Michaleq24/Lokalizator-GPS-GSM/README.md

Katalog zawiera dokumentację i pliki związane z projektem "Lokalizator GPS/GSM".

Autor: Michał Figołuszka  INF s.5 gr.2
