Michaleq24/Lokalizator-GPS-GSM/Dokumentacja/Lokalizator.GPS.GSM_Michał.Figołuszka.pptx

## Lokalizator GPS/GSM

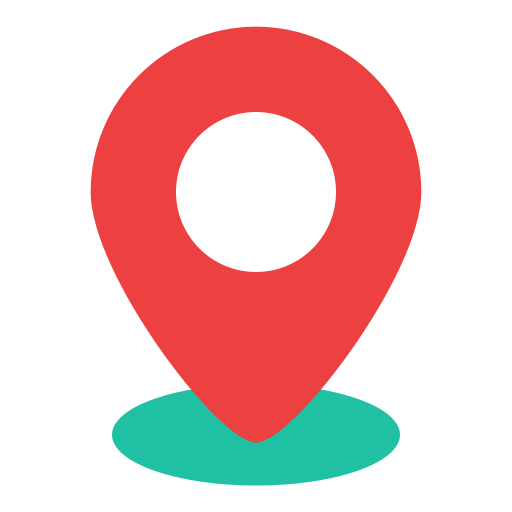
[picture p1: figure]
Map Pin - Free maps and location icons

## Środowisko programistyczne

- STM32CubeIDE 1.19.0
- Język: C++
- Mikrokontroler:
STM32 NUCLEO-L432KC

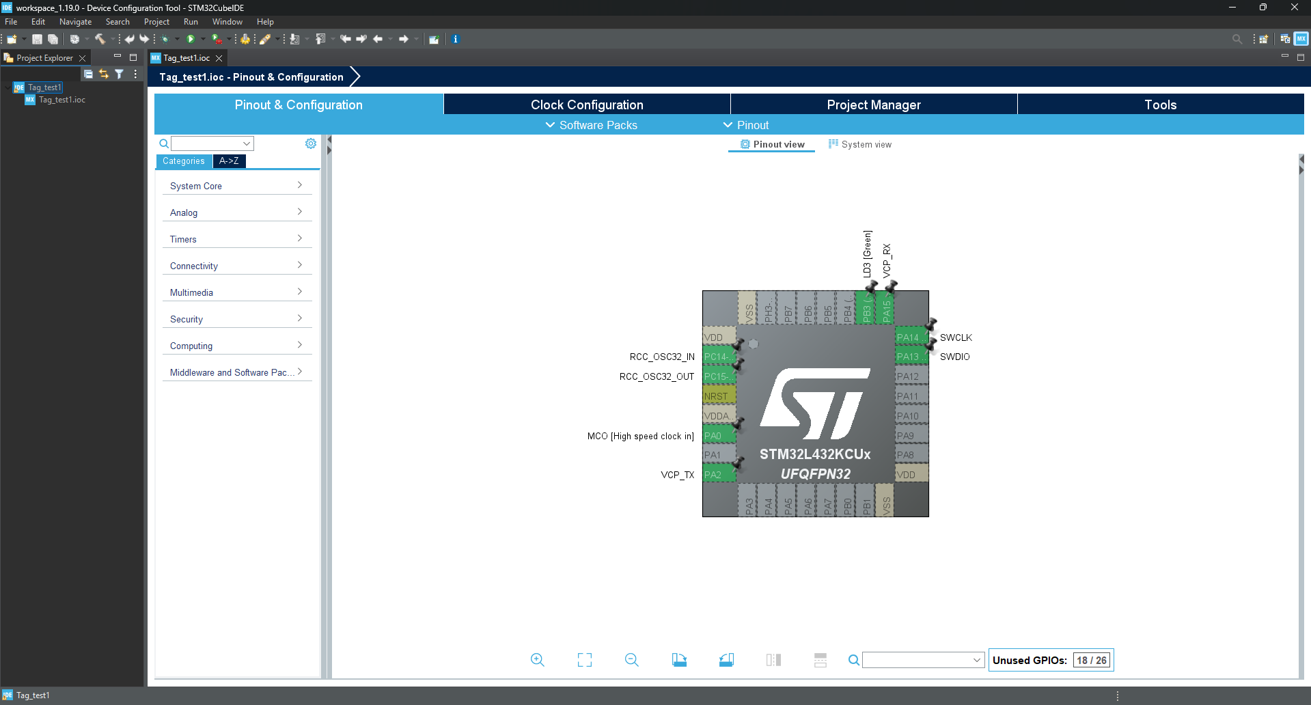
[picture p2: figure]
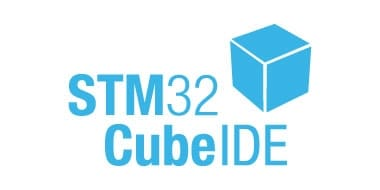
[picture p3: figure]
STM32CubeIDE | Software - STMicroelectronics

## Schemat Blokowy Systemu

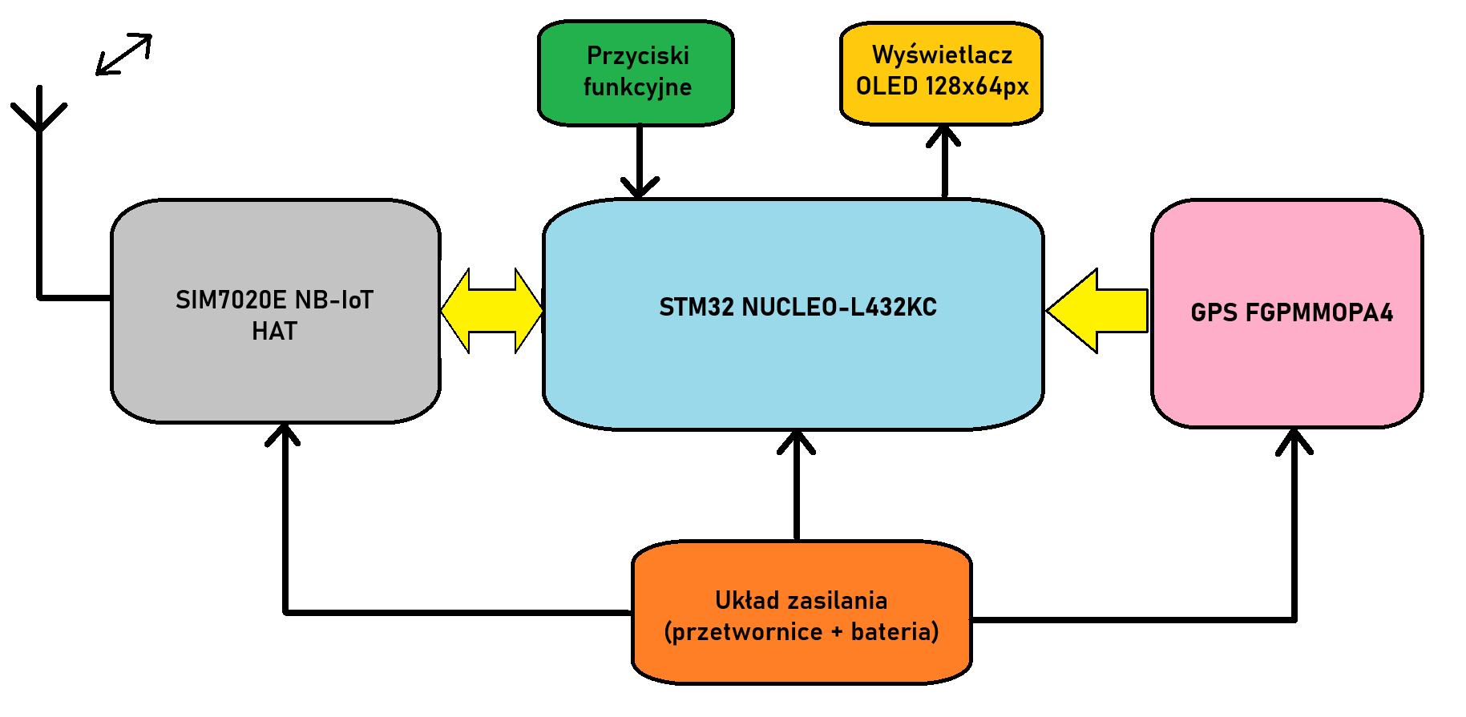
[picture p4: figure]

## Moduły:

- STM32 NUCLEO-L432KC

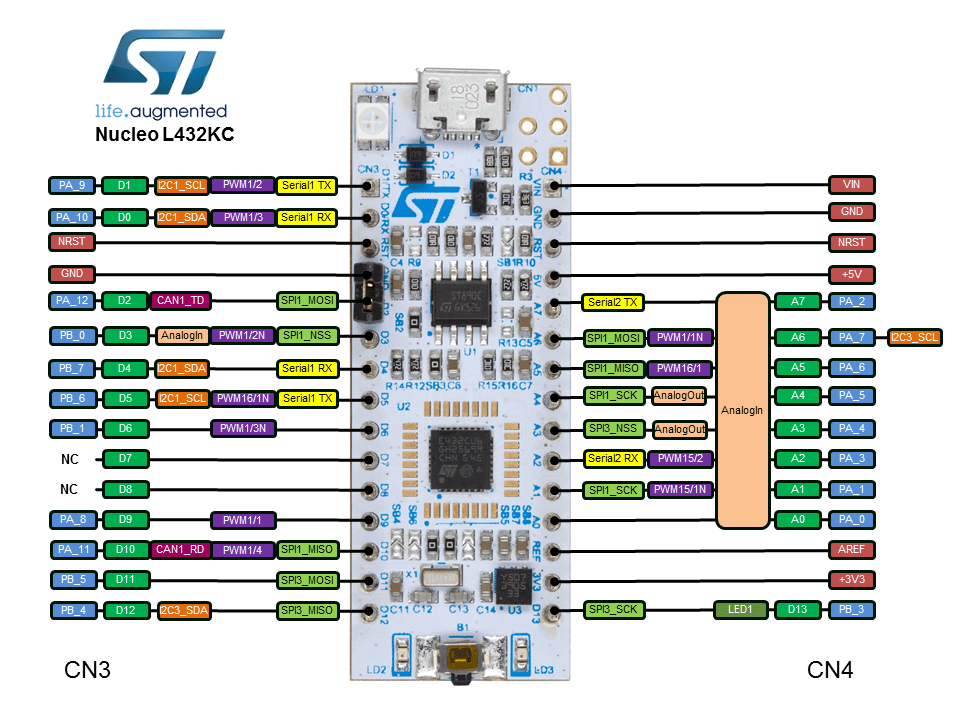
[picture p5: figure]
Foto

Waveshare SIM7020E NB-IoT HAT

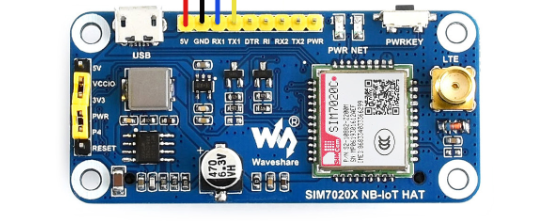
[picture p6: figure]

## Moduły:

- GPS FGPMMOPA4

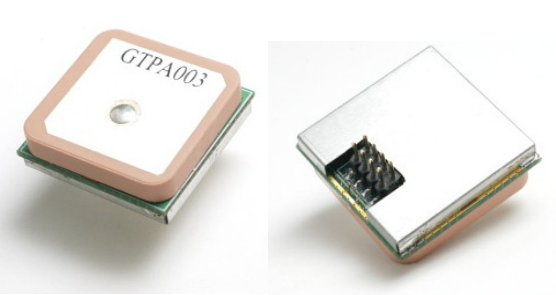
[picture p7: figure]

Wyświetlacz OLED128x64px

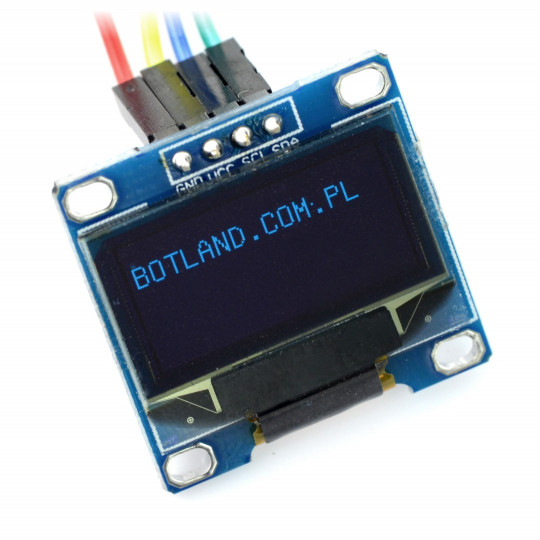
[picture p8: figure]
Wyświetlacz OLED niebieski graficzny 0,96'' 128x64px I2C

## Funkcjonalności:

- Przesył lokalizacji poprzez sieć GSM-LTE na serwer MQTT, możliwy podgląd historii lokalizacji z poziomu innych urządzeń.
- Obsługa przycisków funkcyjnych do kontroli pracy urządzenia.
- Podgląd aktualnej lokalizacji, czasu oraz siły zasięgu sieci GSM na wyświetlaczu.

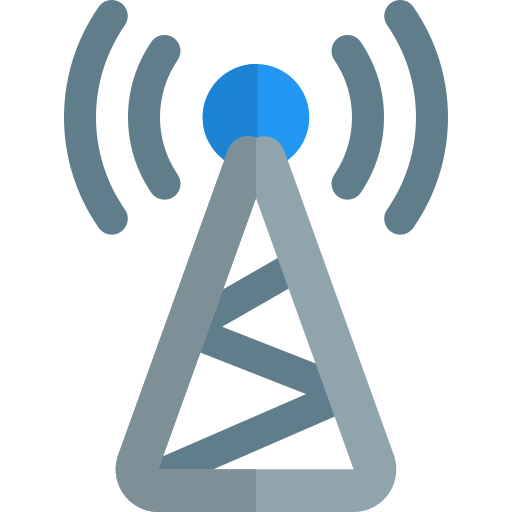
[picture p9: figure]
Ikona Gsm Pixel Perfect Flat | Freepik

## Dziękuję za uwagę

- Michał Figołuszka
