Michaleq24/Lokalizator-GPS-GSM/Dokumentacja/Doxygen_Lokalizator.GPS.GSM_Michał.Figołuszka.pdf

## Lokalizator GPS/GSM

Wygenerowano przez Doxygen 1.10.0

i

1 Topic Index | 1
2 Indeks struktur danych | 3
3 Indeks plików | 5
4 Topic Documentation | 7

Wygenerowano przez Doxygen

ii

5 Dokumentacja struktur danych | 17
6 Dokumentacja plików | 19
Skorowidz | 25

# Rozdział 1

# Topic Index

## 1.1 Topics

Here is a list of all topics with brief descriptions:

Zmienne Interfejsu Uzytkownika | ˙ | 7

### 2 Topic Index

# Rozdział 2

# Indeks struktur danych

## 2.1 Struktury danych

Tutaj znajduj ˛a si˛e struktury danych wraz z ich krótkimi opisami:

OperatorMapping

### 4 Indeks struktur danych

# Rozdział 3

# Indeks plików

## 3.1 Lista plików

Tutaj znajduje si˛e lista wszystkich udokumentowanych plików z ich krótkimi opisami:

main.c

### 6 Indeks plików

# Rozdział 4

# Topic Documentation

## 4.1 Definicje Sprz˛etowe

Definicje

- #define GSM_UART &huart1

Uchwyt UART dla modemu GSM (SIM7670E)
- #define DEBUG_UART &huart2

Uchwyt UART dla GPS (GPS_NEO-6M-0-001)
- #define GSM_PWR_PIN GPIO_PIN_1

Pin steruj ˛acy zasilaniem GSM (PWRKEY)
- #define GSM_PWR_PORT GPIOB

Port steruj ˛acy zasilaniem GSM.
- #define BTN_MID_PIN GPIO_PIN_1

Przycisk Srodkowy (PA1/A1) - ON/OFF Ekran. ´
- #define BTN_LEFT_PIN GPIO_PIN_4

Przycisk Lewy (PA4/A3) - Poprzedni pulpit.
- #define BTN_RIGHT_PIN GPIO_PIN_7

Przycisk Prawy (PA7/A6) - Nast˛epny pulpit.
- #define BTN_PORT GPIOA

Port przycisków.

### 4.1.1 Opis szczegółowy

Mapowanie pinów i peryferiów.

## 4.2 Zmienne Interfejsu U˙zytkownika

Zmienne

- uint8_t current_desktop = 0

Aktualny pulpit (0=GPS, 1=Status, 2=Debug)
- uint8_t screen_on = 1

Stan ekranu (1=Wł ˛aczony, 0=Wył ˛aczony)
- uint32_t last_display_time = 0

Czas ostatniego odswie ´ zenia ekranu (ms) ˙

### 8 Topic Documentation

### 4.2.1 Opis szczegółowy

Stan ekranu i nawigacji.

## 4.3 Zmienne Obsługi Przycisków

Zmienne

- uint32_t btn_check_timer = 0

Timer do próbkowania przycisków (debounce)
- uint8_t btn_mid_last = 1

Ostatni stan przycisku srodkowego (1=puszczony) ´
- uint8_t btn_left_last = 1

Ostatni stan przycisku lewego.
- uint8_t btn_right_last = 1

Ostatni stan przycisku prawego.

### 4.3.1 Opis szczegółowy

Zmienne dla maszyny stanów przycisków i debouncingu.

## 4.4 Zmienne Modułu GSM

Zmienne

- volatile int signal_strength_csq = 99

Moc sygnału (99 = nieznana)
- char network_operator [32] = "Szukam..."

Nazwa operatora sieci.
- volatile uint32_t rx_byte_counter = 0

Licznik odebranych bajtów.
- uint32_t tx_msg_counter = 0

Licznik wysłanych wiadomosci MQTT. ´
- uint8_t rx_char_buffer

Pojedynczy znak z przerwania UART.
- char current_line [64]

Bufor roboczy do składania linii odpowiedzi.
- uint8_t line_idx = 0

Indeks w buforze linii.
- char gsm_last_message [64]

Ostatnia pełna linia (do debugowania)
- char at_buffer [512]

Bufor dla funkcji blokuj ˛acych (GSM_SendAT_Checked)
- uint8_t gsm_powered_on = 0

Flaga stanu zasilania GSM (1=Wł ˛aczony, 0=Wył ˛aczony)

4.5 Słowniki GSM | 9

### 4.4.1 Opis szczegółowy

Bufory i flagi komunikacji z modemem.

## 4.5 Słowniki GSM

Struktury danych

- struct OperatorMapping

Struktura mapuj ˛aca kod operatora na nazw˛e.

Zmienne

- const OperatorMapping op_list [ ]

Lista znanych operatorów w Polsce.

### 4.5.1 Opis szczegółowy

Mapowanie kodów na nazwy.

### 4.5.2 Dokumentacja zmiennych

### 4.5.2.1 op_list

const OperatorMapping op_list[ ]

Wartos´c pocz ˛atkowa: ´

= {
{"26001", "Plus"},
{"26002", "T-Mobile"},
{"26003", "Orange"},
{"26006", "Play"},
{"26012", "Cyfrowy Polsat"}, {"26017", "Aero2"},
{"26098", "Play (Roaming)"} }

Lista znanych operatorów w Polsce.

### 10 Topic Documentation

## 4.6 Zmienne Modułu GPS

Zmienne

- uint8_t gps_rx_char

Znak z przerwania GPS.
- char gps_line_buffer [128]

Bufor na jedn ˛a lini˛e NMEA.
- uint8_t gps_line_idx = 0

Indeks bufora linii.
- volatile uint8_t gps_data_ready = 0

Flaga: nowa linia gotowa do parsowania.
- char gps_main_buffer [128]

Bufor bezpieczny dla p˛etli main.
- char gps_debug_raw [20] = "NO DATA"

Podgl ˛ad surowych danych dla ekranu DEBUG.
- float gps_lat_decimal = 0.0

Szerokos´c geograficzna (format dziesi˛etny) ´
- float gps_lon_decimal = 0.0

Długos´c geograficzna (format dziesi˛etny) ´
- char gps_time_str [16] = "00:00:00"

Czas UTC.
- char gps_date_str [16] = "01.01.2000"

Data.
- char gps_sats [4] = "0"

Liczba widocznych satelitów.
- uint8_t gps_fix_valid = 0

Status Fixa (1 = Jest Fix, 0 = Brak)
- float gps_speed_kmh = 0.0
Aktualna pr˛edkos´c w km/h (u ´ | sredniona z kilku pomiarów) ´

### 4.6.1 Opis szczegółowy

Dane pozycyjne i bufory NMEA.

## 4.7 Logika Wysyłania

Zmienne

- uint32_t last_mqtt_time = 0

Czas ostatniej wysyłki MQTT.
- uint32_t current_interval = 30000

Aktualny interwał wysyłania (ms)
- char current_mode [10] = "INIT"

Aktualny tryb pracy (FAST/SLOW/STATIC/NO_FIX)
- uint32_t last_movement_time = 0

Zmienna do histerezy czasowej (opó´znienie wejscia w tryb STATIC) ´
- float speed_buffer [5] = {0.0}
Bufor kołowy do wygładzania pr˛edkosci GPS ( ´ | srednia krocz ˛aca) ´
- uint8_t speed_buf_idx = 0

4.8 Funkcje GSM | 11

### 4.7.1 Opis szczegółowy

Zmienne steruj ˛ace zachowaniem lokalizatora.

## 4.8 Funkcje GSM

Funkcje

- uint8_t GSM_SendAT_Checked (char ∗cmd, char ∗expect, uint32_t timeout)

Wysyła komend˛e AT i czeka na oczekiwan ˛a odpowied´z.
- int GSM_CheckSignal_Blocking (void)

Sprawdza sił˛e sygnału (AT+CSQ) w trybie blokuj ˛acym.
- void GSM_CheckSIM_Status (char ∗status_buffer)

Sprawdza status karty SIM (AT+CPIN?).
- int GSM_CheckNetwork_Reg (void)

Sprawdza rejestracj˛e w sieci (AT+CEREG?).
- void GSM_GetOperator_Blocking (void)

Pobiera kod operatora (AT+COPS?) i tłumaczy na nazw˛e.
- void GSM_Init_Sequence (void)

Główna sekwencja inicjalizacyjna modemu GSM.
- void GSM_PublishMQTT_Async (char ∗payload)

Publikuje wiadomos´c MQTT w sposób asynchroniczny. ´
- void GSM_Watchdog_Check (void)

Watchdog dla modemu GSM.
- void GSM_Power_On (void)

Bezpieczne wł ˛aczenie zasilania modemu.
- void GSM_Power_Off (void)

Wył ˛aczenie zasilania modemu (Sleep).

### 4.8.1 Opis szczegółowy

Obsługa modemu, komend AT i MQTT.

### 4.8.2 Dokumentacja funkcji

### 4.8.2.1 GSM_CheckNetwork_Reg()

int GSM_CheckNetwork_Reg (

void )

Sprawdza rejestracj˛e w sieci (AT+CEREG?).

Zwraca

Status rejestracji: 1=Home, 5=Roaming, 0/2=Szukam/Brak.

### 12 Topic Documentation

### 4.8.2.2 GSM_CheckSignal_Blocking()

int GSM_CheckSignal_Blocking (

void )

Sprawdza sił˛e sygnału (AT+CSQ) w trybie blokuj ˛acym.

Zwraca

Wartos´c CSQ (0-31) lub 99 (bł ˛ad). ´

### 4.8.2.3 GSM_CheckSIM_Status()

void GSM_CheckSIM_Status (

char ∗ status_buffer )

Sprawdza status karty SIM (AT+CPIN?).

Parametry

status_buffer Bufor wyjsciowy na opis statusu (np. "READY", "PIN LOCK"). ´

### 4.8.2.4 GSM_GetOperator_Blocking()

void GSM_GetOperator_Blocking (

void )

Pobiera kod operatora (AT+COPS?) i tłumaczy na nazw˛e.

Aktualizuje globaln ˛a zmienn ˛a network_operator.

### 4.8.2.5 GSM_Init_Sequence()

void GSM_Init_Sequence (

void )

Główna sekwencja inicjalizacyjna modemu GSM.

1. Sprawdza komunikacj˛e (AT).
2. Ponawia zapytania w przypadku braku odpowiedzi ze strony modemu.
3. Konfiguruje parametry sieci (APN, GPRS).
4. Konfiguruje klienta MQTT i SSL.
5. Ł ˛aczy si˛e z brokerem.

4.8 Funkcje GSM | 13

### 4.8.2.6 GSM_Power_Off()

void GSM_Power_Off (

void )

Wył ˛aczenie zasilania modemu (Sleep).

Wysyła impuls na PWRKEY, aby uspi ´ c modem. Zeruje flag˛e ´ | gsm_powered_on.

### 4.8.2.7 GSM_Power_On()

void GSM_Power_On (

void )

Bezpieczne wł ˛aczenie zasilania modemu.

Wywołuje Watchdoga, który sprawdza czy modem zyje. Je ˙ | sli nie ´ | zyje - ˙ | > Watchdog wykona procedur˛e startow ˛a
(impuls PWRKEY). Ustawia flag˛e gsm_powered_on.

### 4.8.2.8 GSM_PublishMQTT_Async()

void GSM_PublishMQTT_Async (

char ∗ payload )

Publikuje wiadomos´c MQTT w sposób asynchroniczny. ´

Parametry

payload | Tres´c wiadomo ´ | sci do wysłania. ´

Wysyła sekwencj˛e komend AT: TOPIC, PAYLOAD LENGTH, PAYLOAD, PUB. Nie czeka na odpowied´z (Fire and Forget), aby nie blokowac p˛etli głównej. ´

### 4.8.2.9 GSM_SendAT_Checked()

uint8_t GSM_SendAT_Checked (

char ∗ cmd,

char ∗ expect,

uint32_t timeout )

Wysyła komend˛e AT i czeka na oczekiwan ˛a odpowied´z.

Parametry

cmd | Komenda do wysłania.
expect | Oczekiwany ci ˛ag znaków (np. "OK").
timeout | Czas oczekiwania w ms.

### 14 Topic Documentation

Zwraca

1 - Sukces, 0 - Bł ˛ad/Timeout.

Nota

Funkcja blokuj ˛aca. Czysci flagi bł˛edów UART przed wysłaniem. ´

### 4.8.2.10 GSM_Watchdog_Check()

void GSM_Watchdog_Check (

void )

Watchdog dla modemu GSM.

1. Zatrzymuje przerwania UART.
2. Wysyła "AT".
3. Jesli brak "OK" - ´ | > Wykonuje twardy reset (PWRKEY) i reinicjalizacj˛e GSM_Init_Sequence.
4. Wznawia przerwania.

## 4.9 Funkcje GPS

Funkcje

- void GPS_Parse_GPRMC (char ∗nmea)

Parsuje ramk˛e NMEA GPRMC (Recommended Minimum Navigation Information).
- float NMEA_To_Decimal (char ∗nmea_coord, char direction)

Konwertuje współrz˛edne NMEA na format dziesi˛etny (Decimal Degrees).

### 4.9.1 Opis szczegółowy

Parsowanie NMEA i konwersja danych.

### 4.9.2 Dokumentacja funkcji

### 4.9.2.1 GPS_Parse_GPRMC()

void GPS_Parse_GPRMC (

char ∗ nmea )

Parsuje ramk˛e NMEA GPRMC (Recommended Minimum Navigation Information).

4.10 Funkcje Interfejsu | 15

Parametry

nmea Wska´znik do bufora z surow ˛a ramk ˛a.

- Odporna na puste pola (np. "„") dzi˛eki własnej p˛etli parsowania.
- Wyci ˛aga Czas, Dat˛e, Współrz˛edne i Pr˛edkos´c.´
- Oblicza sredni ˛a krocz ˛ac ˛a pr˛edko ´ | sci z 5 ostatnich pomiarów (filtr szumu). ´

### 4.9.2.2 NMEA_To_Decimal()

float NMEA_To_Decimal (

char ∗ nmea_coord,

char direction )

Konwertuje współrz˛edne NMEA na format dziesi˛etny (Decimal Degrees).

Parametry

nmea_coord | String ze współrz˛edn ˛a w formacie NMEA (np. "5003.3430").
direction | Znak kierunku ('N', 'S', 'E', 'W').

Zwraca

float Współrz˛edna w formacie dziesi˛etnym (np. 50.055716).

Nota

Obsługuje ujemne współrz˛edne dla półkul S i W.

## 4.10 Funkcje Interfejsu

Funkcje

- void Handle_Buttons (void)

Obsługa przycisków fizycznych (Maszyna Stanów).

### 4.10.1 Opis szczegółowy

Obsługa przycisków i logiki ekranu.

### 4.10.2 Dokumentacja funkcji

### 4.10.2.1 Handle_Buttons()

void Handle_Buttons (

void )

Obsługa przycisków fizycznych (Maszyna Stanów).
Funkcja nieblokuj ˛aca. Wykonuje debouncing programowy oparty na czasie (50ms). Obsługuje 3 przyciski: Srodkowy ´ (On/Off ekranu), Lewy/Prawy (Zmiana pulpitów). Działa na pinach PA1, PA4, PA7 skonfigurowanych jako Pull-Up.

### 16 Topic Documentation

# Rozdział 5

# Dokumentacja struktur danych

## 5.1 Dokumentacja struktury OperatorMapping

Struktura mapuj ˛aca kod operatora na nazw˛e.

Pola danych

- char ∗ code

Kod numeryczny (np. "26001")
- char ∗ name

Nazwa czytelna (np. "Plus")

### 5.1.1 Opis szczegółowy

Struktura mapuj ˛aca kod operatora na nazw˛e.

Dokumentacja dla tej struktury została wygenerowana z pliku:

- main.c

### 18 Dokumentacja struktur danych

# Rozdział 6

# Dokumentacja plików

## 6.1 Dokumentacja pliku main.c

: Główny plik programu dla projektu "Lokalizator GPS/GSM".

#include "main.h"

#include "ssd1306.h"

#include "ssd1306_fonts.h" #include <stdio.h>

#include <string.h>

#include <stdarg.h>

#include <stdlib.h>

Struktury danych

- struct OperatorMapping

Struktura mapuj ˛aca kod operatora na nazw˛e.

Definicje

- #define GSM_UART &huart1

Uchwyt UART dla modemu GSM (SIM7670E)
- #define DEBUG_UART &huart2

Uchwyt UART dla GPS (GPS_NEO-6M-0-001)
- #define GSM_PWR_PIN GPIO_PIN_1

Pin steruj ˛acy zasilaniem GSM (PWRKEY)
- #define GSM_PWR_PORT GPIOB

Port steruj ˛acy zasilaniem GSM.
- #define BTN_MID_PIN GPIO_PIN_1

Przycisk Srodkowy (PA1/A1) - ON/OFF Ekran. ´
- #define BTN_LEFT_PIN GPIO_PIN_4

Przycisk Lewy (PA4/A3) - Poprzedni pulpit.
- #define BTN_RIGHT_PIN GPIO_PIN_7

Przycisk Prawy (PA7/A6) - Nast˛epny pulpit.
- #define BTN_PORT GPIOA

Port przycisków.

### 20 Dokumentacja plików

Funkcje

- void SystemClock_Config (void)

System Clock Configuration.
- uint8_t GSM_SendAT_Checked (char ∗cmd, char ∗expect, uint32_t timeout)

Wysyła komend˛e AT i czeka na oczekiwan ˛a odpowied´z.
- int GSM_CheckSignal_Blocking (void)

Sprawdza sił˛e sygnału (AT+CSQ) w trybie blokuj ˛acym.
- void GSM_CheckSIM_Status (char ∗status_buffer)

Sprawdza status karty SIM (AT+CPIN?).
- int GSM_CheckNetwork_Reg (void)

Sprawdza rejestracj˛e w sieci (AT+CEREG?).
- void GSM_GetOperator_Blocking (void)

Pobiera kod operatora (AT+COPS?) i tłumaczy na nazw˛e.
- void GSM_Init_Sequence (void)

Główna sekwencja inicjalizacyjna modemu GSM.
- void GSM_PublishMQTT_Async (char ∗payload)

Publikuje wiadomos´c MQTT w sposób asynchroniczny. ´
- void GSM_Watchdog_Check (void)

Watchdog dla modemu GSM.
- void GSM_Power_On (void)

Bezpieczne wł ˛aczenie zasilania modemu.
- void GSM_Power_Off (void)

Wył ˛aczenie zasilania modemu (Sleep).
- void GPS_Parse_GPRMC (char ∗nmea)

Parsuje ramk˛e NMEA GPRMC (Recommended Minimum Navigation Information).
- float NMEA_To_Decimal (char ∗nmea_coord, char direction)

Konwertuje współrz˛edne NMEA na format dziesi˛etny (Decimal Degrees).
- void Handle_Buttons (void)

Obsługa przycisków fizycznych (Maszyna Stanów).
- void HAL_UART_RxCpltCallback (UART_HandleTypeDef ∗huart)

Callback przerwania odbioru UART.
- int main (void)

Główny punkt wejscia programu. ´
- void HAL_UART_ErrorCallback (UART_HandleTypeDef ∗huart)
- void Error_Handler (void)

This function is executed in case of error occurrence.

Zmienne

- I2C_HandleTypeDef hi2c1

Uchwyt do obsługi I2C (Ekran OLED)
- UART_HandleTypeDef huart1

Uchwyt do obsługi UART1 (GSM)
- UART_HandleTypeDef huart2

Uchwyt do obsługi UART2 (GPS)
- uint8_t current_desktop = 0

Aktualny pulpit (0=GPS, 1=Status, 2=Debug)
- uint8_t screen_on = 1

Stan ekranu (1=Wł ˛aczony, 0=Wył ˛aczony)

6.1 Dokumentacja pliku main.c | 21 • uint32_t last_display_time = 0
Czas ostatniego odswie ´ | zenia ekranu (ms) ˙
- uint32_t btn_check_timer = 0

Timer do próbkowania przycisków (debounce)
- uint8_t btn_mid_last = 1

Ostatni stan przycisku srodkowego (1=puszczony) ´
- uint8_t btn_left_last = 1

Ostatni stan przycisku lewego.
- uint8_t btn_right_last = 1

Ostatni stan przycisku prawego.
- volatile int signal_strength_csq = 99

Moc sygnału (99 = nieznana)
- char network_operator [32] = "Szukam..."

Nazwa operatora sieci.
- volatile uint32_t rx_byte_counter = 0

Licznik odebranych bajtów.
- uint32_t tx_msg_counter = 0

Licznik wysłanych wiadomosci MQTT. ´
- uint8_t rx_char_buffer

Pojedynczy znak z przerwania UART.
- char current_line [64]

Bufor roboczy do składania linii odpowiedzi.
- uint8_t line_idx = 0

Indeks w buforze linii.
- char gsm_last_message [64]

Ostatnia pełna linia (do debugowania)
- char at_buffer [512]

Bufor dla funkcji blokuj ˛acych (GSM_SendAT_Checked)
- uint8_t gsm_powered_on = 0

Flaga stanu zasilania GSM (1=Wł ˛aczony, 0=Wył ˛aczony)
- const OperatorMapping op_list [ ]

Lista znanych operatorów w Polsce.
- uint8_t gps_rx_char

Znak z przerwania GPS.
- char gps_line_buffer [128]

Bufor na jedn ˛a lini˛e NMEA.
- uint8_t gps_line_idx = 0

Indeks bufora linii.
- volatile uint8_t gps_data_ready = 0

Flaga: nowa linia gotowa do parsowania.
- char gps_main_buffer [128]

Bufor bezpieczny dla p˛etli main.
- char gps_debug_raw [20] = "NO DATA"

Podgl ˛ad surowych danych dla ekranu DEBUG.
- float gps_lat_decimal = 0.0

Szeroko

s´c geograficzna (format dziesi˛etny) ´
- float gps_lon_decimal = 0.0

Długo

s´c geograficzna (format dziesi˛etny) ´
- char gps_time_str [16] = "00:00:00"

Czas UTC.
- char gps_date_str [16] = "01.01.2000"

### 22 Dokumentacja plików

Data.
- char gps_sats [4] = "0"

Liczba widocznych satelitów.
- uint8_t gps_fix_valid = 0

Status Fixa (1 = Jest Fix, 0 = Brak)
- float gps_speed_kmh = 0.0
Aktualna pr˛edkos´c w km/h (u ´ | sredniona z kilku pomiarów) ´
- uint32_t last_mqtt_time = 0

Czas ostatniej wysyłki MQTT.
- uint32_t current_interval = 30000

Aktualny interwał wysyłania (ms)
- char current_mode [10] = "INIT"

Aktualny tryb pracy (FAST/SLOW/STATIC/NO_FIX)
- uint32_t last_movement_time = 0

Zmienna do histerezy czasowej (opó´znienie wejscia w tryb STATIC) ´
- float speed_buffer [5] = {0.0}
Bufor kołowy do wygładzania pr˛edkosci GPS ( ´ | srednia krocz ˛aca) ´
- uint8_t speed_buf_idx = 0

### 6.1.1 Opis szczegółowy

: Główny plik programu dla projektu "Lokalizator GPS/GSM".

Autor

: Michał Figołuszka

Data

: 06.01.2026

Wersja

: 1.0

Ten plik zawiera główn ˛a p˛etl˛e programu oraz logik˛e sterowania lokalizatorem GPS. Główne funkcjonalnosci: ´

- Obsługa modułu GSM (SIM7670E) poprzez komendy AT (MQTT, SSL).
- Obsługa modułu GPS (GPS_NEO-6M-0-001) poprzez parsowanie ramek NMEA (GPRMC).
- Inteligentne zarz ˛adzanie energi ˛a (Smart Beacon) i interwałami wysyłania wiadomosci. ´
- Interfejs uzytkownika na ekranie OLED SSD1306 (3 pulpity, sterowane poprzez 3 przyciski). ˙
- Watchdog programowy i sprz˛etowy reset modemu.

Uwaga

Copyright (c) 2026 STMicroelectronics. All rights reserved.

### 6.1.2 Dokumentacja funkcji

### 6.1.2.1 Error_Handler()

void Error_Handler (

void )

This function is executed in case of error occurrence.

6.1 Dokumentacja pliku main.c | 23

Zwracane wartosci ´

None

### 6.1.2.2 HAL_UART_RxCpltCallback()

void HAL_UART_RxCpltCallback (

UART_HandleTypeDef ∗ huart )

Callback przerwania odbioru UART.

Parametry

huart Wska´znik do struktury UART.

Obsługuje odbiór znak po znaku dla GSM (UART1) i GPS (UART2). Dla GSM: Składa linie i ignoruje echo. Dla GPS: Wykrywa koniec linii (
) i ustawia flag˛e gps_data_ready.

### 6.1.2.3 main()

int main (

void )

Główny punkt wejscia programu. ´

Zwracane wartosci ´

int

### 6.1.2.4 SystemClock_Config()

void SystemClock_Config (

void )

System Clock Configuration.

Zwracane wartosci ´

None

Configure the main internal regulator output voltage

Configure LSE Drive Capability

Initializes the RCC Oscillators according to the specified parameters in the RCC_OscInitTypeDef structure.

Initializes the RCC Oscillators according to the specified parameters in the RCC_OscInitTypeDef structure.

Initializes the CPU, AHB and APB buses clocks

### 24 Dokumentacja plików

# Skorowidz

Definicje Sprz˛etowe, 7

Error_Handler
main.c, 22

Funkcje GPS, 14
GPS_Parse_GPRMC, 14
NMEA_To_Decimal, 15
Funkcje GSM, 11
GSM_CheckNetwork_Reg, 11
GSM_CheckSignal_Blocking, 11 GSM_CheckSIM_Status, 12
GSM_GetOperator_Blocking, 12 GSM_Init_Sequence, 12
GSM_Power_Off, 12
GSM_Power_On, 13
GSM_PublishMQTT_Async, 13
GSM_SendAT_Checked, 13
GSM_Watchdog_Check, 14
Funkcje Interfejsu, 15
Handle_Buttons, 15

GPS_Parse_GPRMC
Funkcje GPS, 14
GSM_CheckNetwork_Reg
Funkcje GSM, 11
GSM_CheckSignal_Blocking
Funkcje GSM, 11
GSM_CheckSIM_Status
Funkcje GSM, 12
GSM_GetOperator_Blocking
Funkcje GSM, 12
GSM_Init_Sequence
Funkcje GSM, 12
GSM_Power_Off
Funkcje GSM, 12
GSM_Power_On
Funkcje GSM, 13
GSM_PublishMQTT_Async
Funkcje GSM, 13
GSM_SendAT_Checked
Funkcje GSM, 13
GSM_Watchdog_Check
Funkcje GSM, 14

HAL_UART_RxCpltCallback
main.c, 23
Handle_Buttons
Funkcje Interfejsu, 15

Logika Wysyłania, 10

main
main.c, 23
main.c, 19
Error_Handler, 22
HAL_UART_RxCpltCallback, 23 main, 23
SystemClock_Config, 23

NMEA_To_Decimal
Funkcje GPS, 15

op_list
Słowniki GSM, 9
OperatorMapping, 17

SystemClock_Config
main.c, 23
Słowniki GSM, 9
op_list, 9
Zmienne Interfejsu Uzytkownika, ˙ | 7
Zmienne Modułu GPS, 10
Zmienne Modułu GSM, 8
Zmienne Obsługi Przycisków, 8
