Michaleq24/Lokalizator-GPS-GSM/Hardware/SCHEMAT.Lokalizator.GPS.GSM_Michał.Figołuszka.png

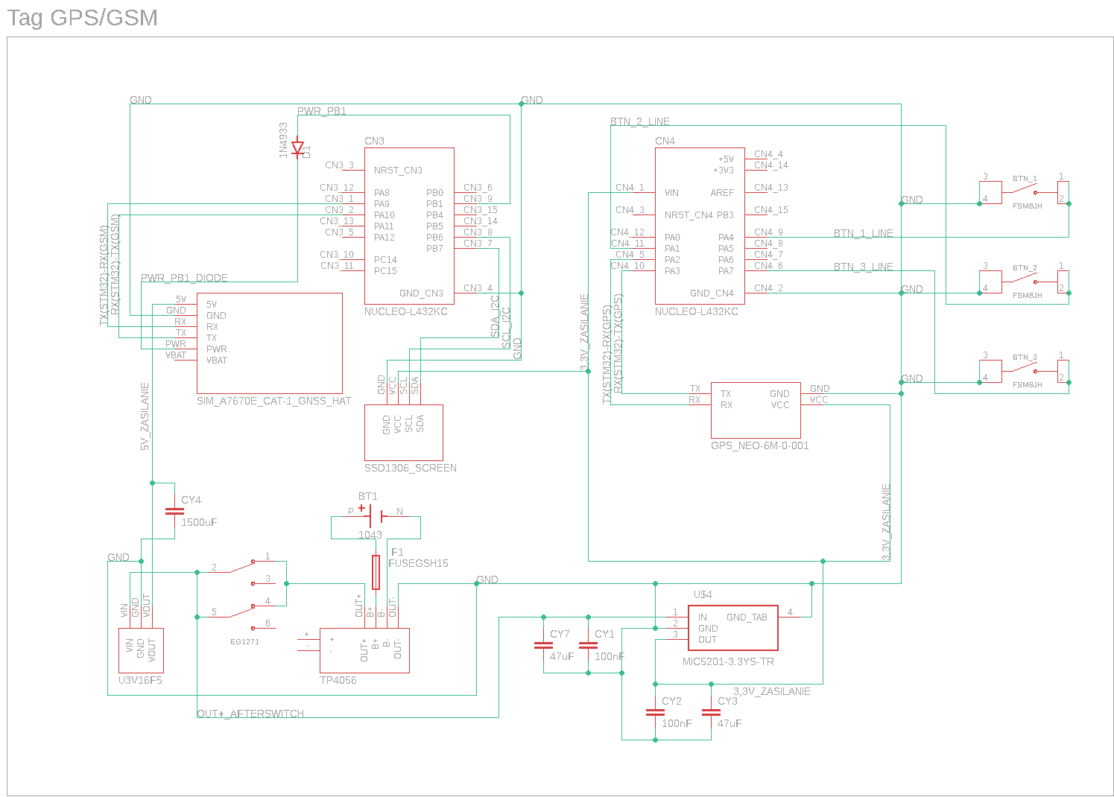
Hardware/SCHEMAT.Lokalizator.GPS.GSM_Michał.Figołuszka.png
