Michaleq24/Lokalizator-GPS-GSM/Hardware/Lokalizator.GPS.GSM_Michał.Figołuszka.brd

## EAGLE design Hardware/Lokalizator.GPS.GSM_Michał.Figołuszka.brd (2026-01-10)

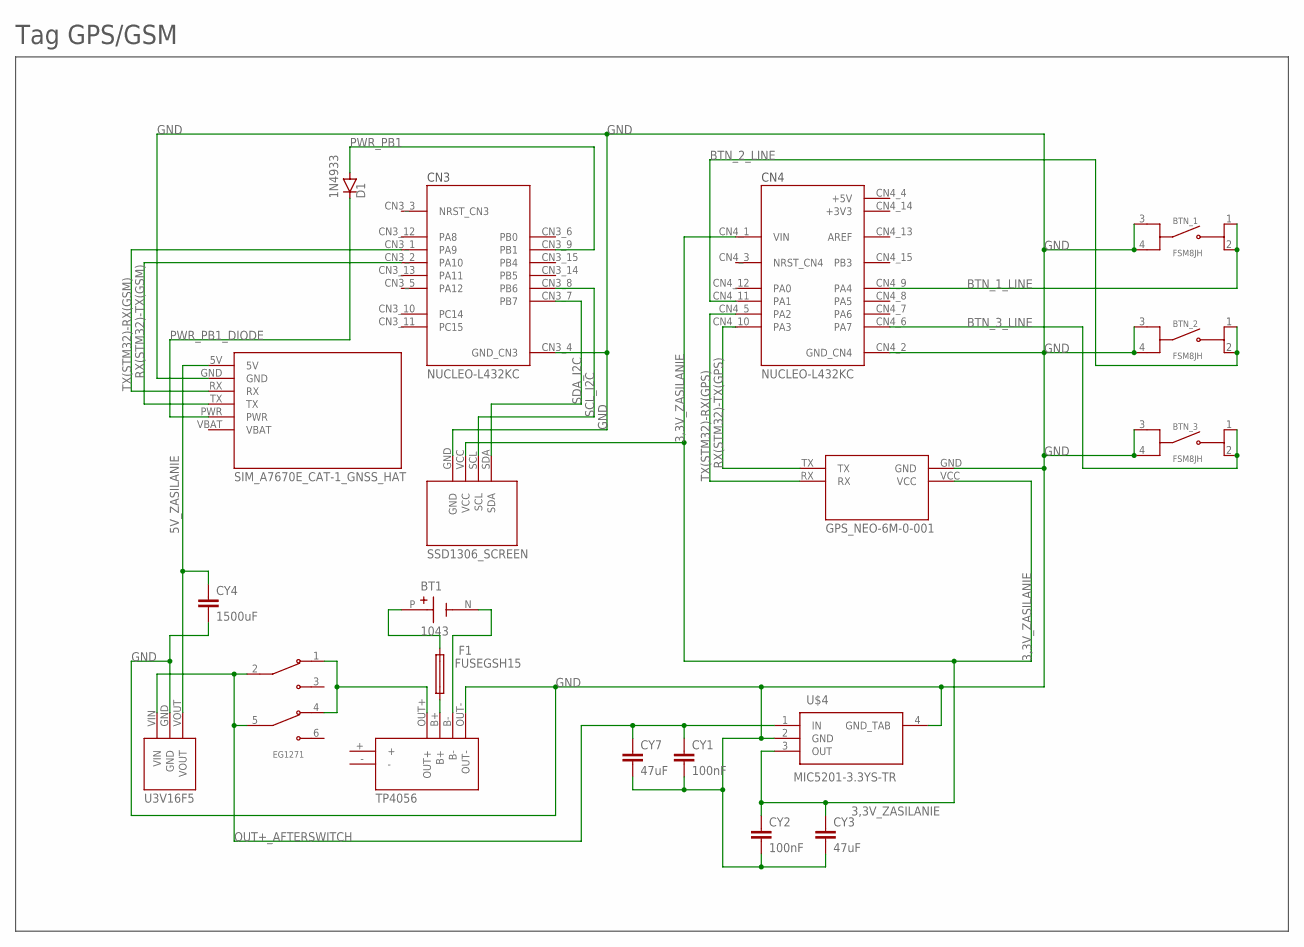
[picture p28: schematic Lokalizator.GPS.GSM_Michał.Figołuszka.sch]

Parts:
BT1: 1043; BAT_1043
BTN_1, BTN_2, BTN_3: FSM8JH; SW_FSM8JH
CY1, CY2: 100nF; YC7B5
CY3, CY7: 47uF; YC7B5
CY4: 1500uF; YC7B5
D1: 1N4933; DO41-10
F1: FUSEGSH15; GSH15
S1: EG1271; SW_EG1271
U1: NUCLEO-L432KC; MODULE_NUCLEO-L432KC
U$1: U3V16F5
U$2: TP4056
U$3: SSD1306_SCREEN
U$4: MIC5201-3.3YS-TR; SOT230P700X180-4N
U$6: SIM7020E_NB-IOT_HAT
U$7: GPS_NEO-6M-0-001

Connections:
3,3V_ZASILANIE: CY2.1, CY3.1, U1.CN4_1 (VIN), U$3.VCC, U$4.3 (OUT), U$7.VCC
5V_ZASILANIE: CY4.1, U$1.VOUT, U$6.5V
+3V3: U1.CN4_14 (+3V3)
+5V: U1.CN4_4 (+5V)
B+: BT1.P (POS), F1.2
B+_2: F1.1, U$2.B+
B-: BT1.N (NEG), U$2.B-
BTN_1_LINE: BTN_1.1 (NO_1), BTN_1.2 (NO_2), U1.CN4_9 (PA4)
BTN_2_LINE: BTN_2.1 (NO_1), BTN_2.2 (NO_2), U1.CN4_11 (PA1)
BTN_3_LINE: BTN_3.1 (NO_1), BTN_3.2 (NO_2), U1.CN4_6 (PA7)
GND: BTN_1.3 (COM_3), BTN_1.4 (COM_4), BTN_2.3 (COM_3), BTN_2.4 (COM_4), BTN_3.3 (COM_3), BTN_3.4 (COM_4), CY1.2, CY2.2, CY3.2, CY4.2, CY7.2, U1.CN3_4 (GND_CN3), U1.CN4_2 (GND_CN4), U$1.GND, U$2.OUT-, U$3.GND, U$4.2 (GND), U$4.4 (GND_TAB), U$6.GND, U$7.GND
OUT+: S1.1 (NC1), S1.4 (NC2), U$2.OUT+
OUT+_AFTERSWITCH: CY1.1, CY7.1, S1.2 (COM1), S1.5 (COM2), U$1.VIN, U$4.1 (IN)
PWR_PB1: D1.A, U1.CN3_9 (PB1)
PWR_PB1_DIODE: D1.C, U$6.PWR
RX(STM32)-TX(GPS): U1.CN4_10 (PA3), U$7.TX
RX(STM32)-TX(GSM): U1.CN3_2 (PA10), U$6.TX
SCL_I2C: U1.CN3_8 (PB6), U$3.SCL
SDA_I2C: U1.CN3_7 (PB7), U$3.SDA
TX(STM32)-RX(GPS): U1.CN4_5 (PA2), U$7.RX
TX(STM32)-RX(GSM): U1.CN3_1 (PA9), U$6.RX

Notes on the sheet:
Tag GPS/GSM

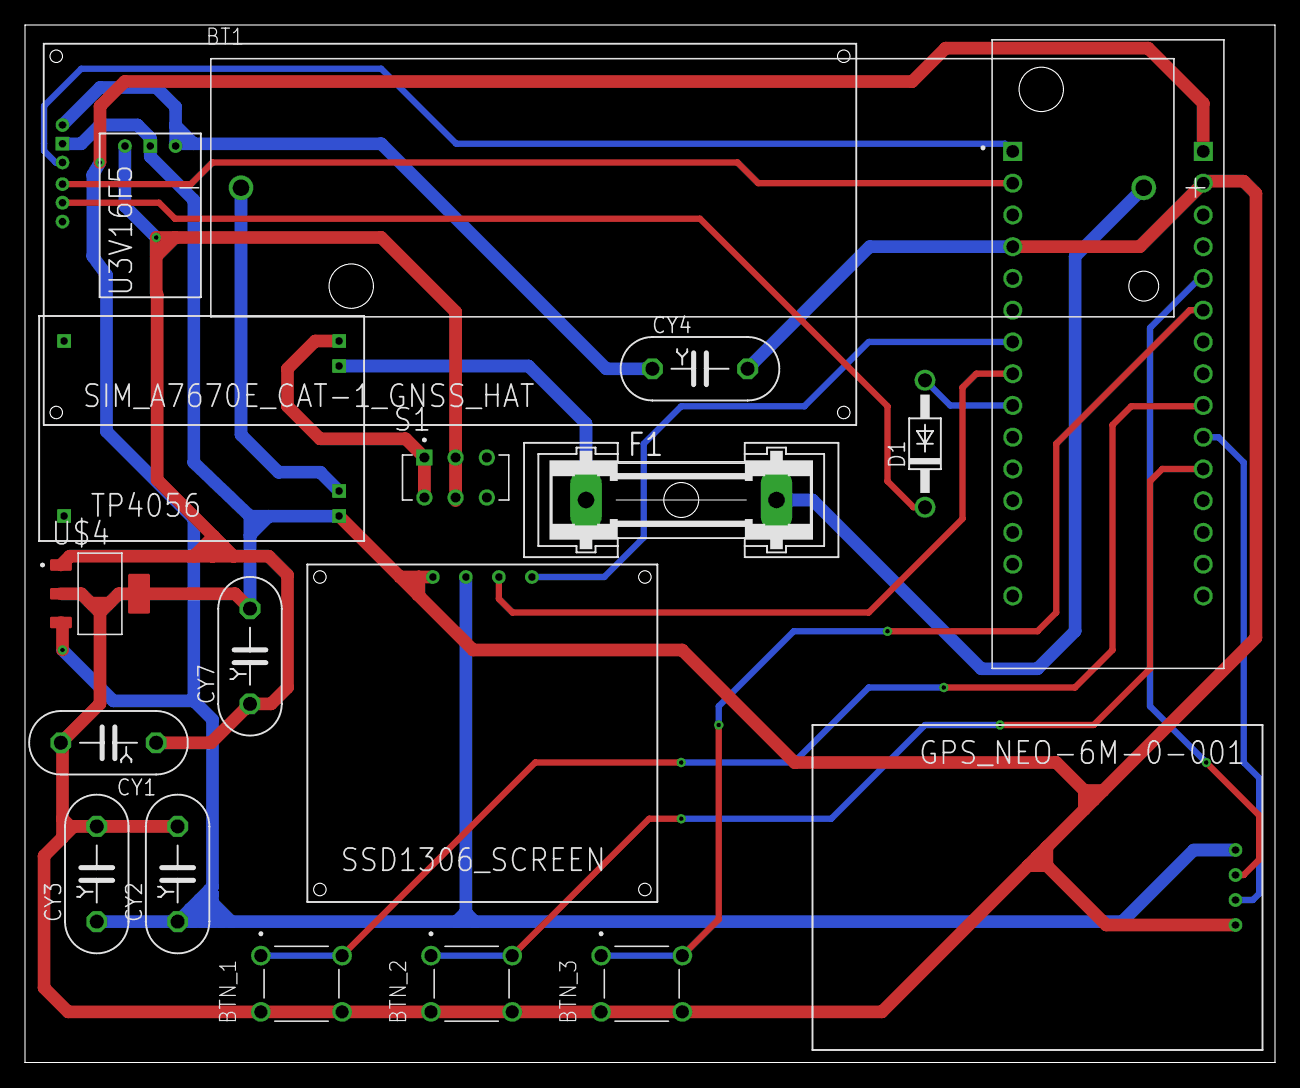
[picture p29: board Lokalizator.GPS.GSM_Michał.Figołuszka.brd from above]

Board: 2 copper layers, 100.0 x 83.0 mm, 19 parts (0 on the bottom side), 19 nets.
