Michaleq24/Lokalizator-GPS-GSM/(commit log)

2026-01-10 Dodany projekt dla środowiska STM32CubeIDE
2026-01-10 Dodano zakładkę Hardware
    [Lokalizator.GPS.GSM_Michał.Figołuszka.brd, Lokalizator.GPS.GSM_Michał.Figołuszka.sch]
